hsgw/tartan/README.md

Tartan
================================

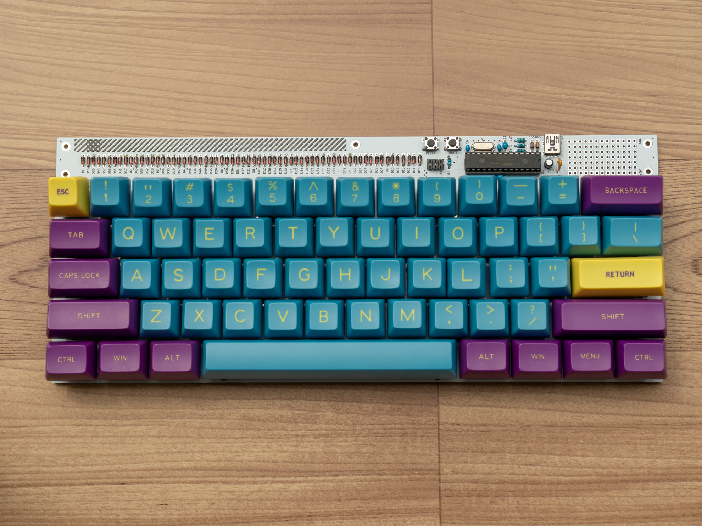
[picture p1: doc/img/tartan.jpg]
tartan


60% keyboard made by through hole components only. 

Atmega328p with VUSB on [QMK firmware](https://github.com/qmk/qmk_firmware).

[Build guide and bom is here](./doc)
[ビルドガイドとパーツリストはこちら](./doc)
