hsgw/tartan/doc/img/tartan_bottom.jpg

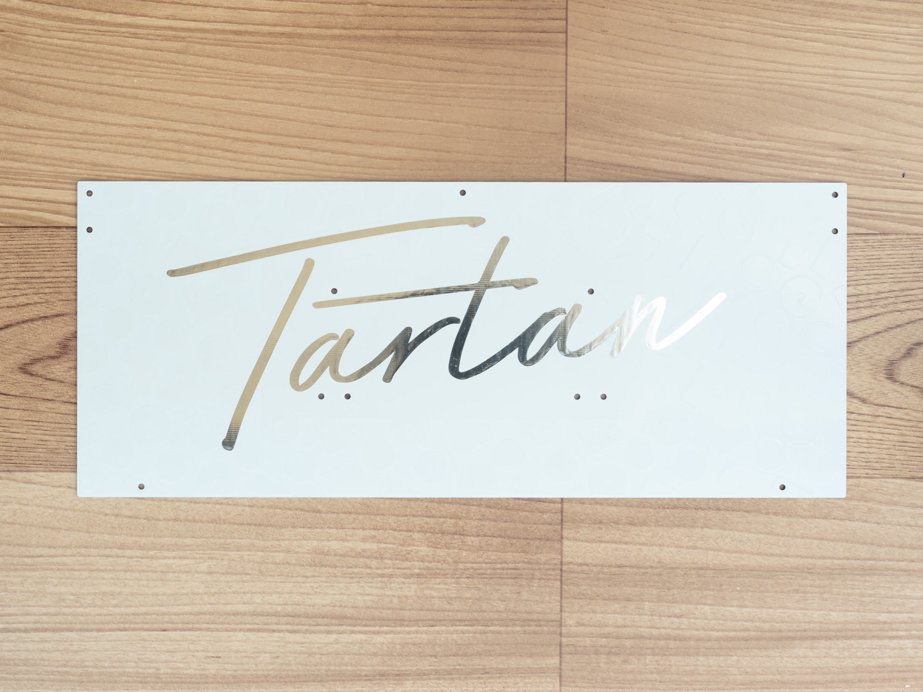
doc/img/tartan_bottom.jpg
