hsgw/tartan/doc/img/tartan_pcb.jpg

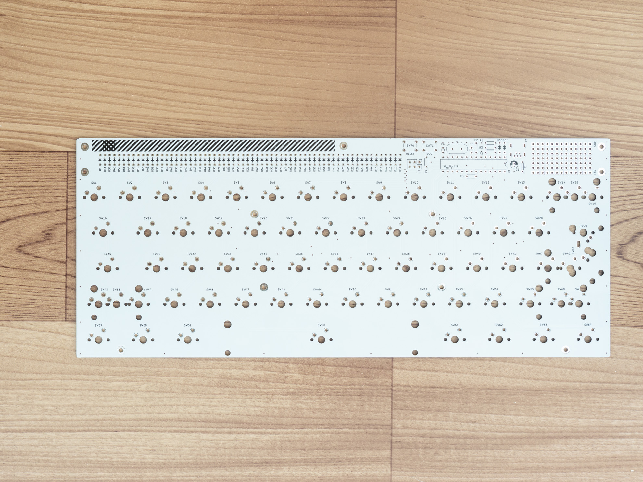
doc/img/tartan_pcb.jpg
