hsgw/tartan/doc/img/tartan_pcb_bottom.jpg

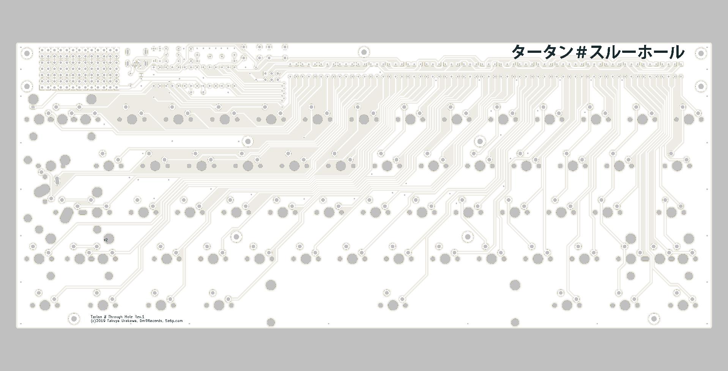
doc/img/tartan_pcb_bottom.jpg
