hsgw/tartan/doc/img/tartan_pcb_northfacing.jpg

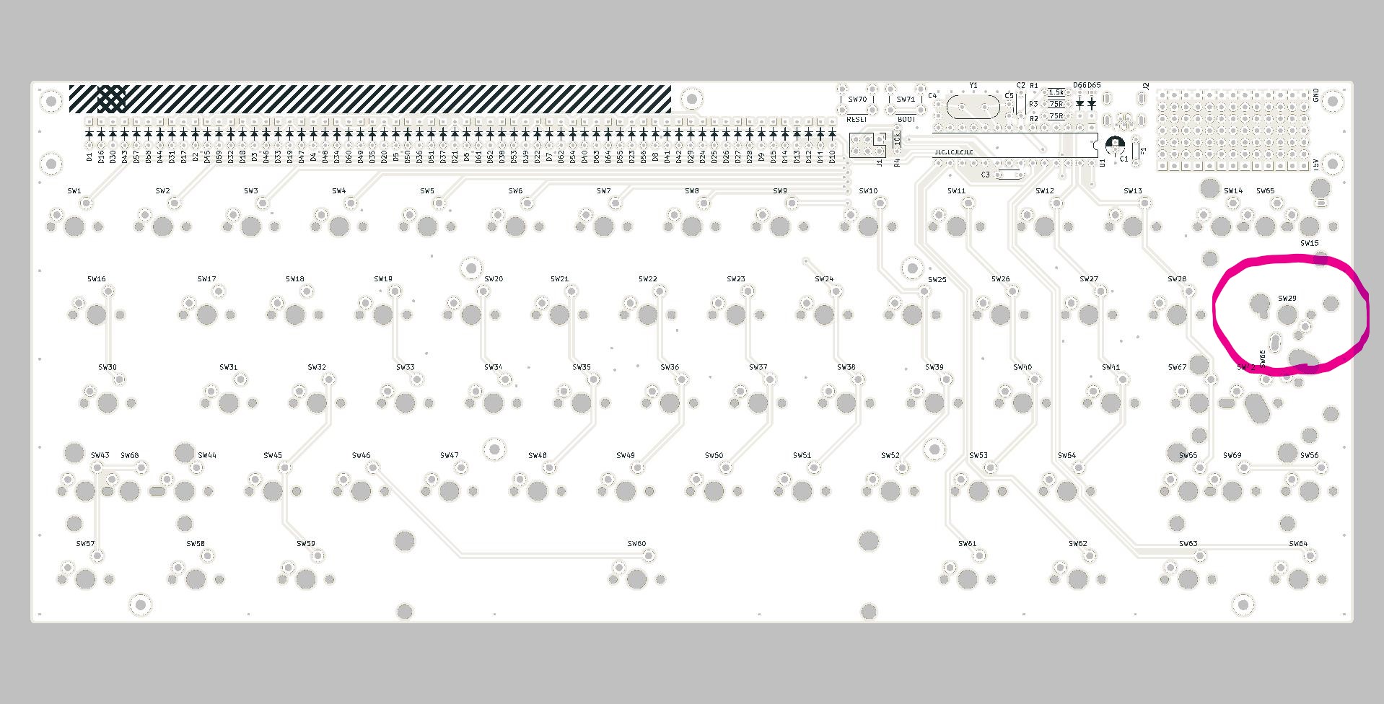
doc/img/tartan_pcb_northfacing.jpg
