hsgw/tartan/doc/jp/BOM.md

# BOM
## Tartan kitに含まれているもの
| Ref | 個数 | |
|---|---|---|
| C1 | 1 | 電解コンデンサ 4.7uF |
| C2, C3 | 2 | 積層セラミックコンデンサ 0.1uF (5.08mmピッチ) |
| C4, C5 | 2 | 積層セラミックコンデンサ 22pF (2.54mmピッチ)  |
| D1-D64 | 64 | 1N4148または互換品 |
| D65, D66 | 2 | 3.6Vツェナーダイオード |
| F1 | 1 | ポリフューズ 100mA |
| J1 | 1 | 3x2 ピンヘッダ |
| J2 | 1 | USB miniB コネクタ |
| R1 | 1 | 抵抗 1.5kΩ (茶緑黒茶茶) |
| R2, R3 | 2 | 抵抗 75Ω (紫緑黒金茶) |
| R4 | 1 | 抵抗 10kΩ (茶黒黒赤茶) |
| SW70, 71 | 2 | タクトスイッチ |
| U1 | 1 | ATMEGA328-PU |
| Y1 | 1 | クリスタル 16MHz |
| ICSocket(U1) | 1 | 28ピンICソケット |
| Screw | 16 | M2*8mm ネジ |
| Spacer | 5 | M2*10mm スペーサ |
| Nut | 22 | M2ナット |
| PCB | 1 | Main PCB |
| PCB | 1 | Bottom PCB |
| Cover | 1 | アクリルカバー |

## Tartan kitに含まれていないもの
- Cherry MX互換スイッチ
**PCB Mount(5pin)タイプ**
- PCB Mount スタビライザー
- キーキャップ
- USB miniB ケーブル
