hsgw/tartan/doc/img/assembly/4.JPG

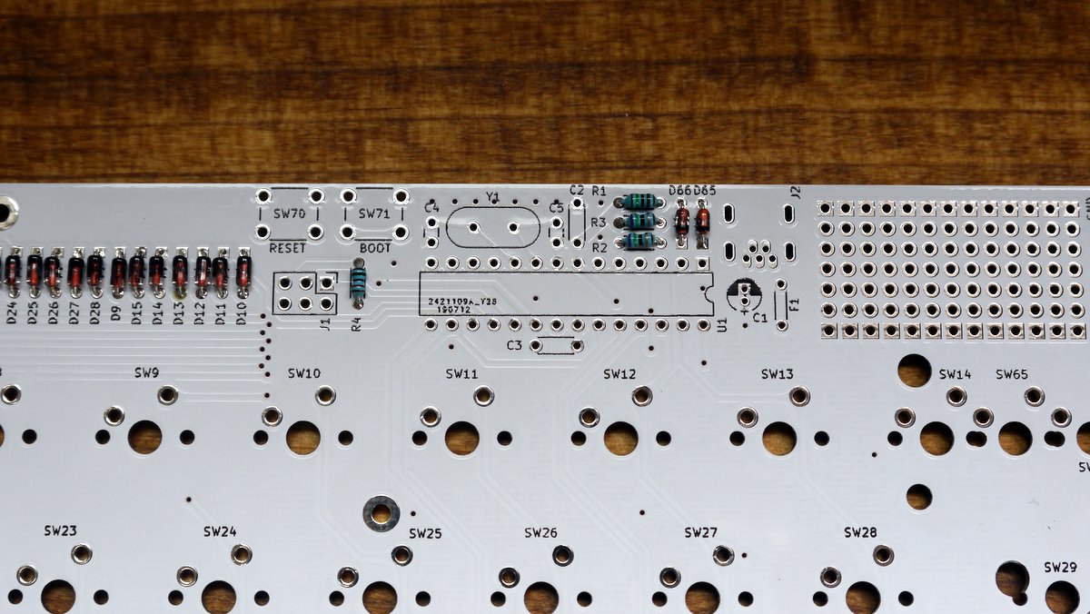
doc/img/assembly/4.JPG
