hsgw/tartan/(threads)

Thread 1 (2019-11-10):

Missing Acrylic Cover Schematic

davidv3rs, 2019-11-10:
Is it available?
