hsgw/tartan/(commit log)

2019-05-21 fix alpha issues
    [tartan.kicad_pcb, tartan.sch]
2019-08-05 Update BOM.md
    fix value
2019-09-06 update PCB rev.1
    [tartan.kicad_pcb, tartan_bottom.kicad_pcb]
