hsgw/tartan/(notices)

Notices in the files:
pcb/tartan_bottom.kicad_pcb:
(c)2019 Takuya Urakawa, Dm9Records.com, 5z6p.com
pcb/tartan.kicad_pcb:
(c)2019 Takuya Urakawa, Dm9Records, 5z6p.com
